pickplace-de/hexagon/Hardware/Kicad/RA8M1.kicad_pcb

## KiCad design Hardware/Kicad/RA8M1.kicad_pcb (2025-03-24)

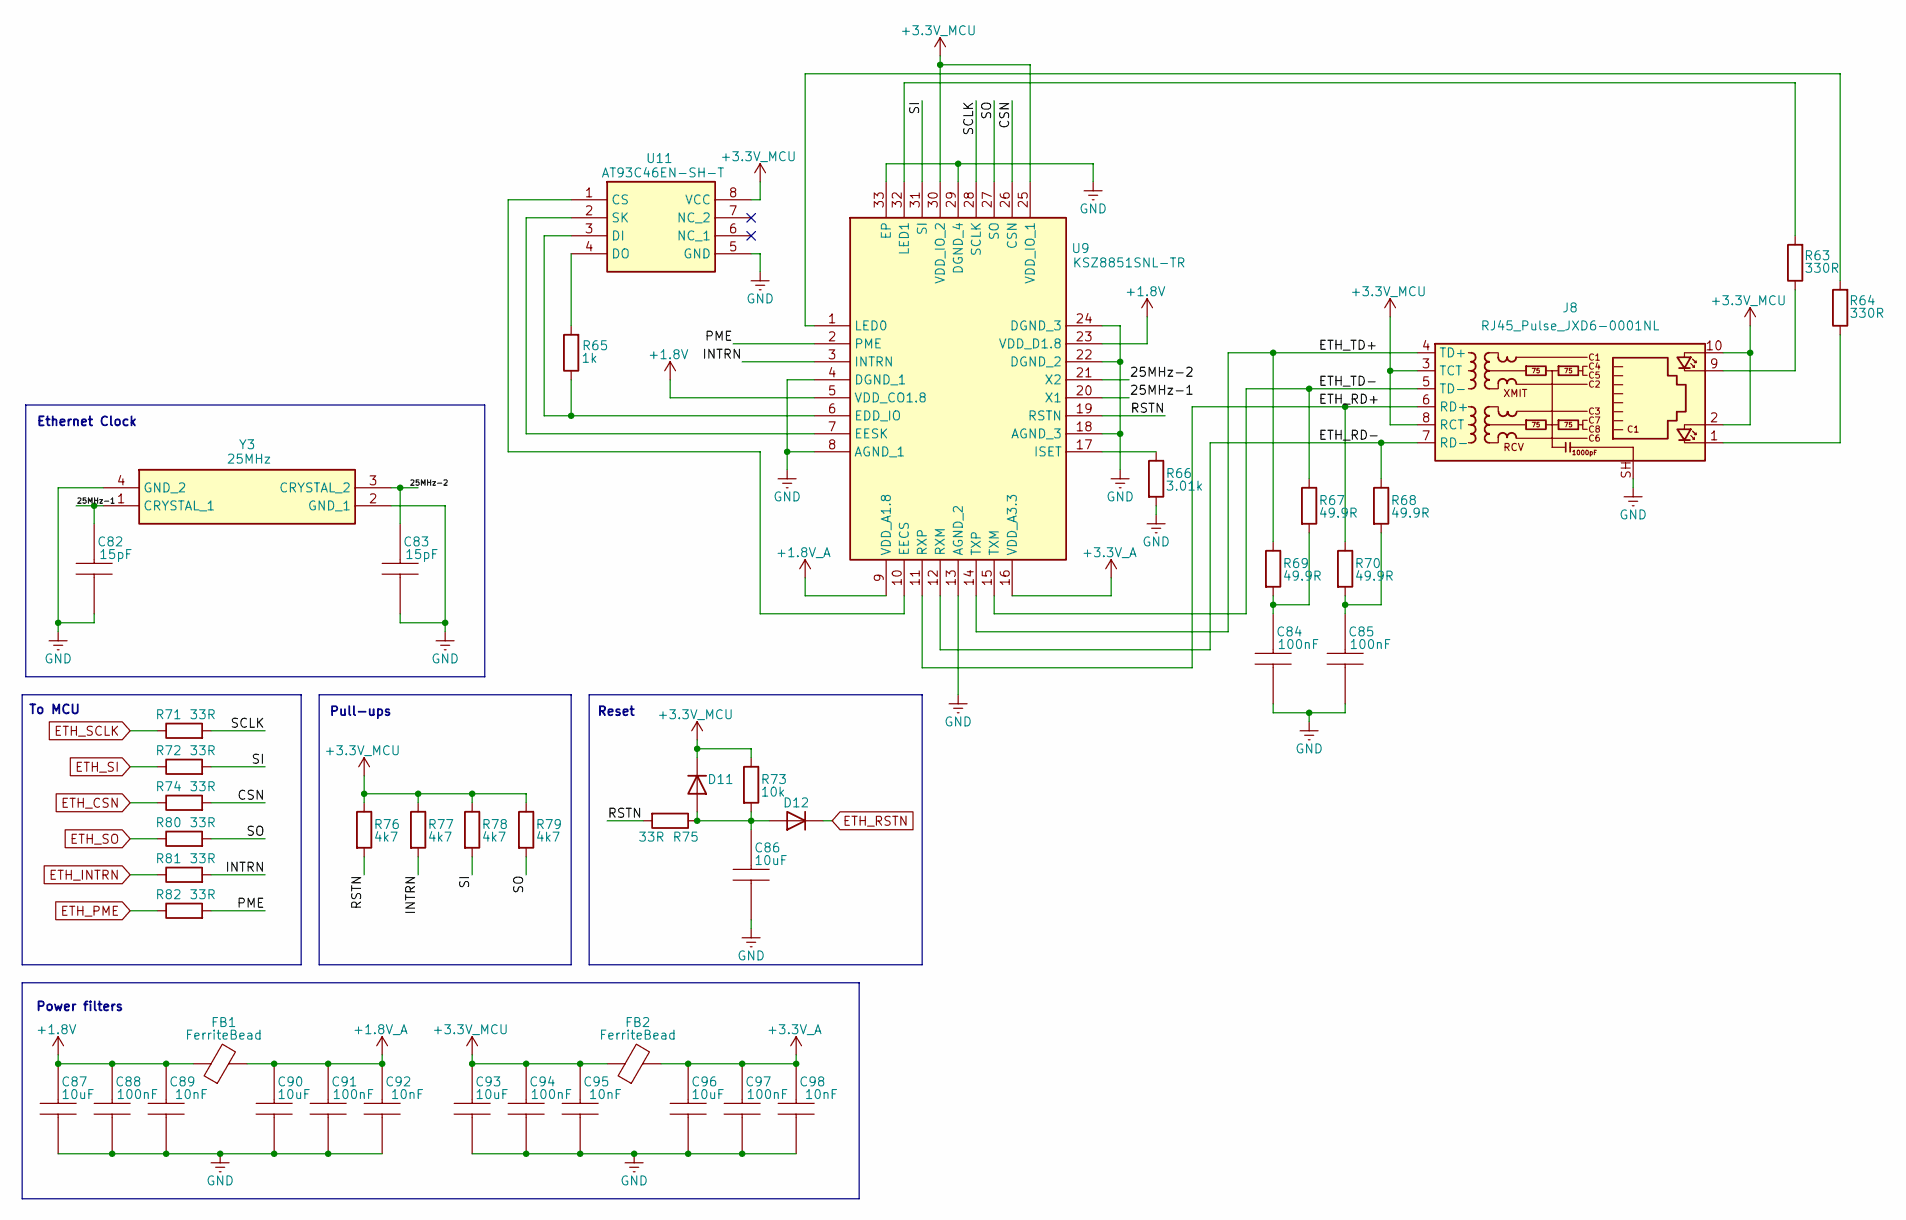
[picture p2: schematic Ethernet.kicad_sch]

Parts:
C82, C83: 15pF; C_0402_1005Metric; MPN 885012005008
C84, C85, C88, C91, C94, C97: 100nF; C_0402_1005Metric; MPN 885012205092
C86, C87, C90, C93, C96: 10uF; C_0402_1005Metric; MPN 885012105020
C89, C92, C95, C98: 10nF; C_0402_1005Metric; MPN 885012205031
D11, D12: 1N4148W; D_SOD-123; MPN 1N4148W-7-F
FB1, FB2: FerriteBead; L_0805_2012Metric; MPN 742792040
J8: RJ45_Pulse_JXD6-0001NL; RJ45_Pulse_JXD6-0001NL_Horizontal; MPN JXD6-0001NL
R63, R64: 330R; R_0402_1005Metric; MPN 560112110231
R65: 1k; R_0402_1005Metric; MPN 560112110012
R66: 3.01k; R_0402_1005Metric; MPN CR0402-FX-3011GLF
R67, R68, R69, R70: 49.9R; R_0402_1005Metric; MPN 560112110002
R71, R72, R74, R75, R80, R81, R82: 33R; R_0402_1005Metric; MPN 560112110004
R73: 10k; R_0402_1005Metric; MPN 560112110020
R76, R77, R78, R79: 4k7; R_0402_1005Metric; MPN 560112110245
U9: KSZ8851SNL-TR; QFN50P500X500X100-33N-D; Mouser Part Number 998-KSZ8851SNLTR
U11: AT93C46EN-SH-T; SOIC127P600X175-8N; Mouser Part Number 556-A93C46ENSHT
Y3: 25MHz; 830108208209; Mouser Part Number 830107871909

Connections:
+1.8V: C87.2, C88.2, C89.2, FB1.1, U9.5 (VDD_CO1.8), U9.23 (VDD_D1.8); also elsewhere on the board
+1.8V_A: C90.2, C91.2, C92.2, FB1.2, U9.9 (VDD_A1.8)
+3.3V_A: C96.2, C97.2, C98.2, FB2.2, U9.16 (VDD_A3.3)
+3.3V_MCU: C93.2, C94.2, C95.2, D11.1 (K), FB2.1, J8.2, J8.3 (TCT), J8.8 (RCT), J8.10, R73.1, R76.1, R77.1, R78.1, R79.1, U9.25 (VDD_IO_1), U9.30 (VDD_IO_2), U11.8 (VCC); also elsewhere on the board
/ETHERNET/25MHz-1: C82.2, U9.20 (X1), Y3.1 (CRYSTAL_1)
/ETHERNET/25MHz-2: C83.2, U9.21 (X2), Y3.3 (CRYSTAL_2)
/ETHERNET/CSN: R74.2, U9.26 (CSN)
/ETHERNET/ETH_RD+: J8.6 (RD+), R70.1, U9.11 (RXP)
/ETHERNET/ETH_RD-: J8.7 (RD-), R68.1, U9.12 (RXM)
/ETHERNET/ETH_TD+: J8.4 (TD+), R69.1, U9.14 (TXP)
/ETHERNET/ETH_TD-: J8.5 (TD-), R67.1, U9.15 (TXM)
/ETHERNET/INTRN: R77.2, R81.2, U9.3 (INTRN)
/ETHERNET/PME: R82.2, U9.2 (PME)
/ETHERNET/RSTN: R75.2, R76.2, U9.19 (RSTN)
/ETHERNET/SCLK: R71.2, U9.28 (SCLK)
/ETHERNET/SI: R72.2, R78.2, U9.31 (SI)
/ETHERNET/SO: R79.2, R80.2, U9.27 (SO)
ETH_CSN: R74.1; also elsewhere on the board
ETH_INTRN: R81.1; also elsewhere on the board
ETH_PME: R82.1; also elsewhere on the board
ETH_RSTN: D12.1 (K); also elsewhere on the board
ETH_SCLK: R71.1; also elsewhere on the board
ETH_SI: R72.1; also elsewhere on the board
ETH_SO: R80.1; also elsewhere on the board
GND: C82.1, C83.1, C84.1, C85.1, C86.1, C87.1, C88.1, C89.1, C90.1, C91.1, C92.1, C93.1, C94.1, C95.1, C96.1, C97.1, C98.1, J8.SH, R66.2, U9.4 (DGND_1), U9.8 (AGND_1), U9.13 (AGND_2), U9.18 (AGND_3), U9.22 (DGND_2), U9.24 (DGND_3), U9.29 (DGND_4), U9.33 (EP), U11.5 (GND), Y3.2 (GND_1), Y3.4 (GND_2); also elsewhere on the board
unnamed: C84.2, R67.2, R69.2
unnamed: C85.2, R68.2, R70.2
unnamed: C86.2, D11.2 (A), D12.2 (A), R73.2, R75.1
unnamed: J8.1, R64.1
unnamed: J8.9, R63.1
unnamed: R66.1, U9.17 (ISET)
unnamed: R64.2, U9.1 (LED0)
unnamed: R63.2, U9.32 (LED1)
unnamed: U9.10 (EECS), U11.1 (CS)
unnamed: R65.1, U9.6 (EDD_IO), U11.3 (DI)
unnamed: R65.2, U11.4 (DO)
unnamed: U9.7 (EESK), U11.2 (SK)

Notes on the sheet:
Power filters
To MCU
Pull-ups
Reset
Ethernet Clock

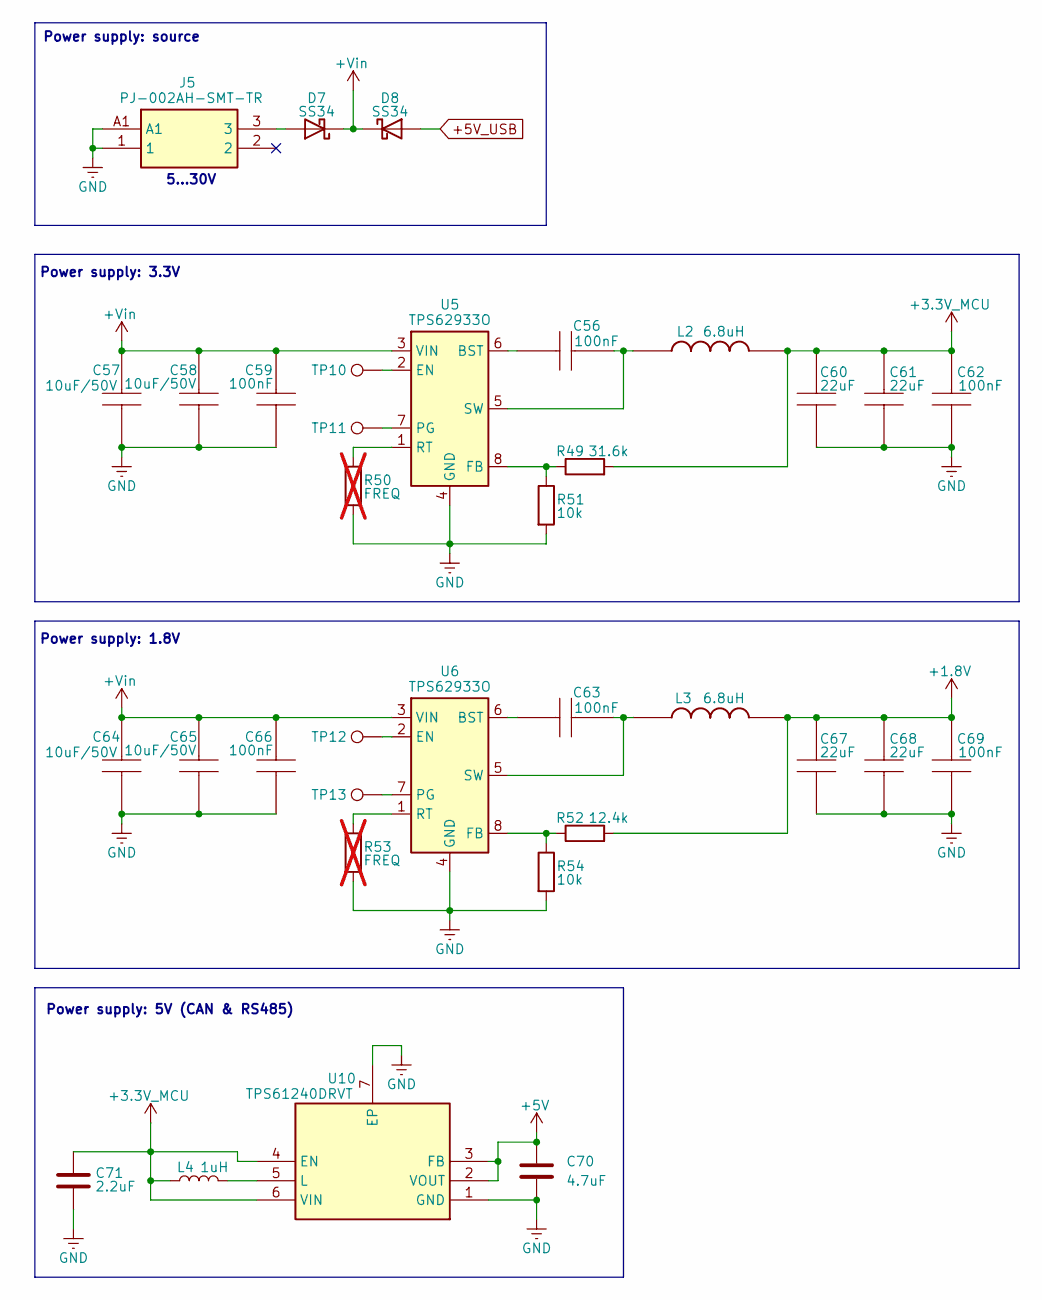
[picture p3: schematic PS.kicad_sch]

Parts:
C56, C59, C62, C63, C66, C69: 100nF; C_0402_1005Metric; MPN 885012205092
C57, C58, C64, C65: 10uF/50V; C_0805_2012Metric; MPN C2012X5R1H106K125AC
C60, C61, C67, C68: 22uF; C_0805_2012Metric; MPN 885012107005
C70: 4.7uF; C_0402_1005Metric; MPN 885012105008
C71: 2.2uF; C_0402_1005Metric; MPN 885012105007
D7, D8: SS34; D_SMA
J5: PJ-002AH-SMT-TR; PJ002AHSMTTR; Mouser Part Number 490-PJ-002AH-SMT-TR
L2, L3: 6.8uH; INDPM4141X310N; Mouser Part Number 710-74438357068
L4: 1uH; L_0603_1608Metric; MPN 74479763210A
R49: 31.6k; R_0402_1005Metric; MPN CR0603-FX-3162ELF
R50, R53: FREQ; R_0402_1005Metric; MPN 560112110001; not fitted
R51, R54: 10k; R_0402_1005Metric; MPN 560112110020
R52: 12.4k; R_0402_1005Metric; MPN CR0402-FX-1242GLF
TP10, TP11, TP12, TP13: TestPoint_0.5mm
U5, U6: TPS62933O; SOT-583-8; MPN TPS62933ODRLR
U10: TPS61240DRVT; SON65P200X200X80-7N; Mouser Part Number 595-TPS61240DRVT

Connections:
+1.8V: C67.2, C68.2, C69.2, L3.2, R52.2; also elsewhere on the board
+3.3V_MCU: C60.2, C61.2, C62.2, C71.1, L2.2, L4.1, R49.2, U10.4 (EN), U10.6 (VIN); also elsewhere on the board
+5V: C70.1, U10.2 (VOUT), U10.3 (FB); also elsewhere on the board
+5V_USB: D8.2 (A); also elsewhere on the board
+Vin: C57.2, C58.2, C59.2, C64.2, C65.2, C66.2, D7.1 (K), D8.1 (K), U5.3 (VIN), U6.3 (VIN)
GND: C57.1, C58.1, C59.1, C60.1, C61.1, C62.1, C64.1, C65.1, C66.1, C67.1, C68.1, C69.1, C70.2, C71.2, J5.1, J5.A1, R50.2, R51.2, R53.2, R54.2, U5.4 (GND), U6.4 (GND), U10.1 (GND), U10.7 (EP); also elsewhere on the board
unnamed: D7.2 (A), J5.3
unnamed: C56.2, U5.6 (BST)
unnamed: TP10.1, U5.2 (EN)
unnamed: R49.1, R51.1, U5.8 (FB)
unnamed: TP11.1, U5.7 (PG)
unnamed: R50.1, U5.1 (RT)
unnamed: C56.1, L2.1, U5.5 (SW)
unnamed: C63.2, U6.6 (BST)
unnamed: TP12.1, U6.2 (EN)
unnamed: R52.1, R54.1, U6.8 (FB)
unnamed: TP13.1, U6.7 (PG)
unnamed: R53.1, U6.1 (RT)
unnamed: C63.1, L3.1, U6.5 (SW)
unnamed: L4.2, U10.5 (L)

Notes on the sheet:
Power supply: 5V (CAN & RS485)
Power supply: 3.3V
Power supply: source
Power supply: 1.8V
5...30V

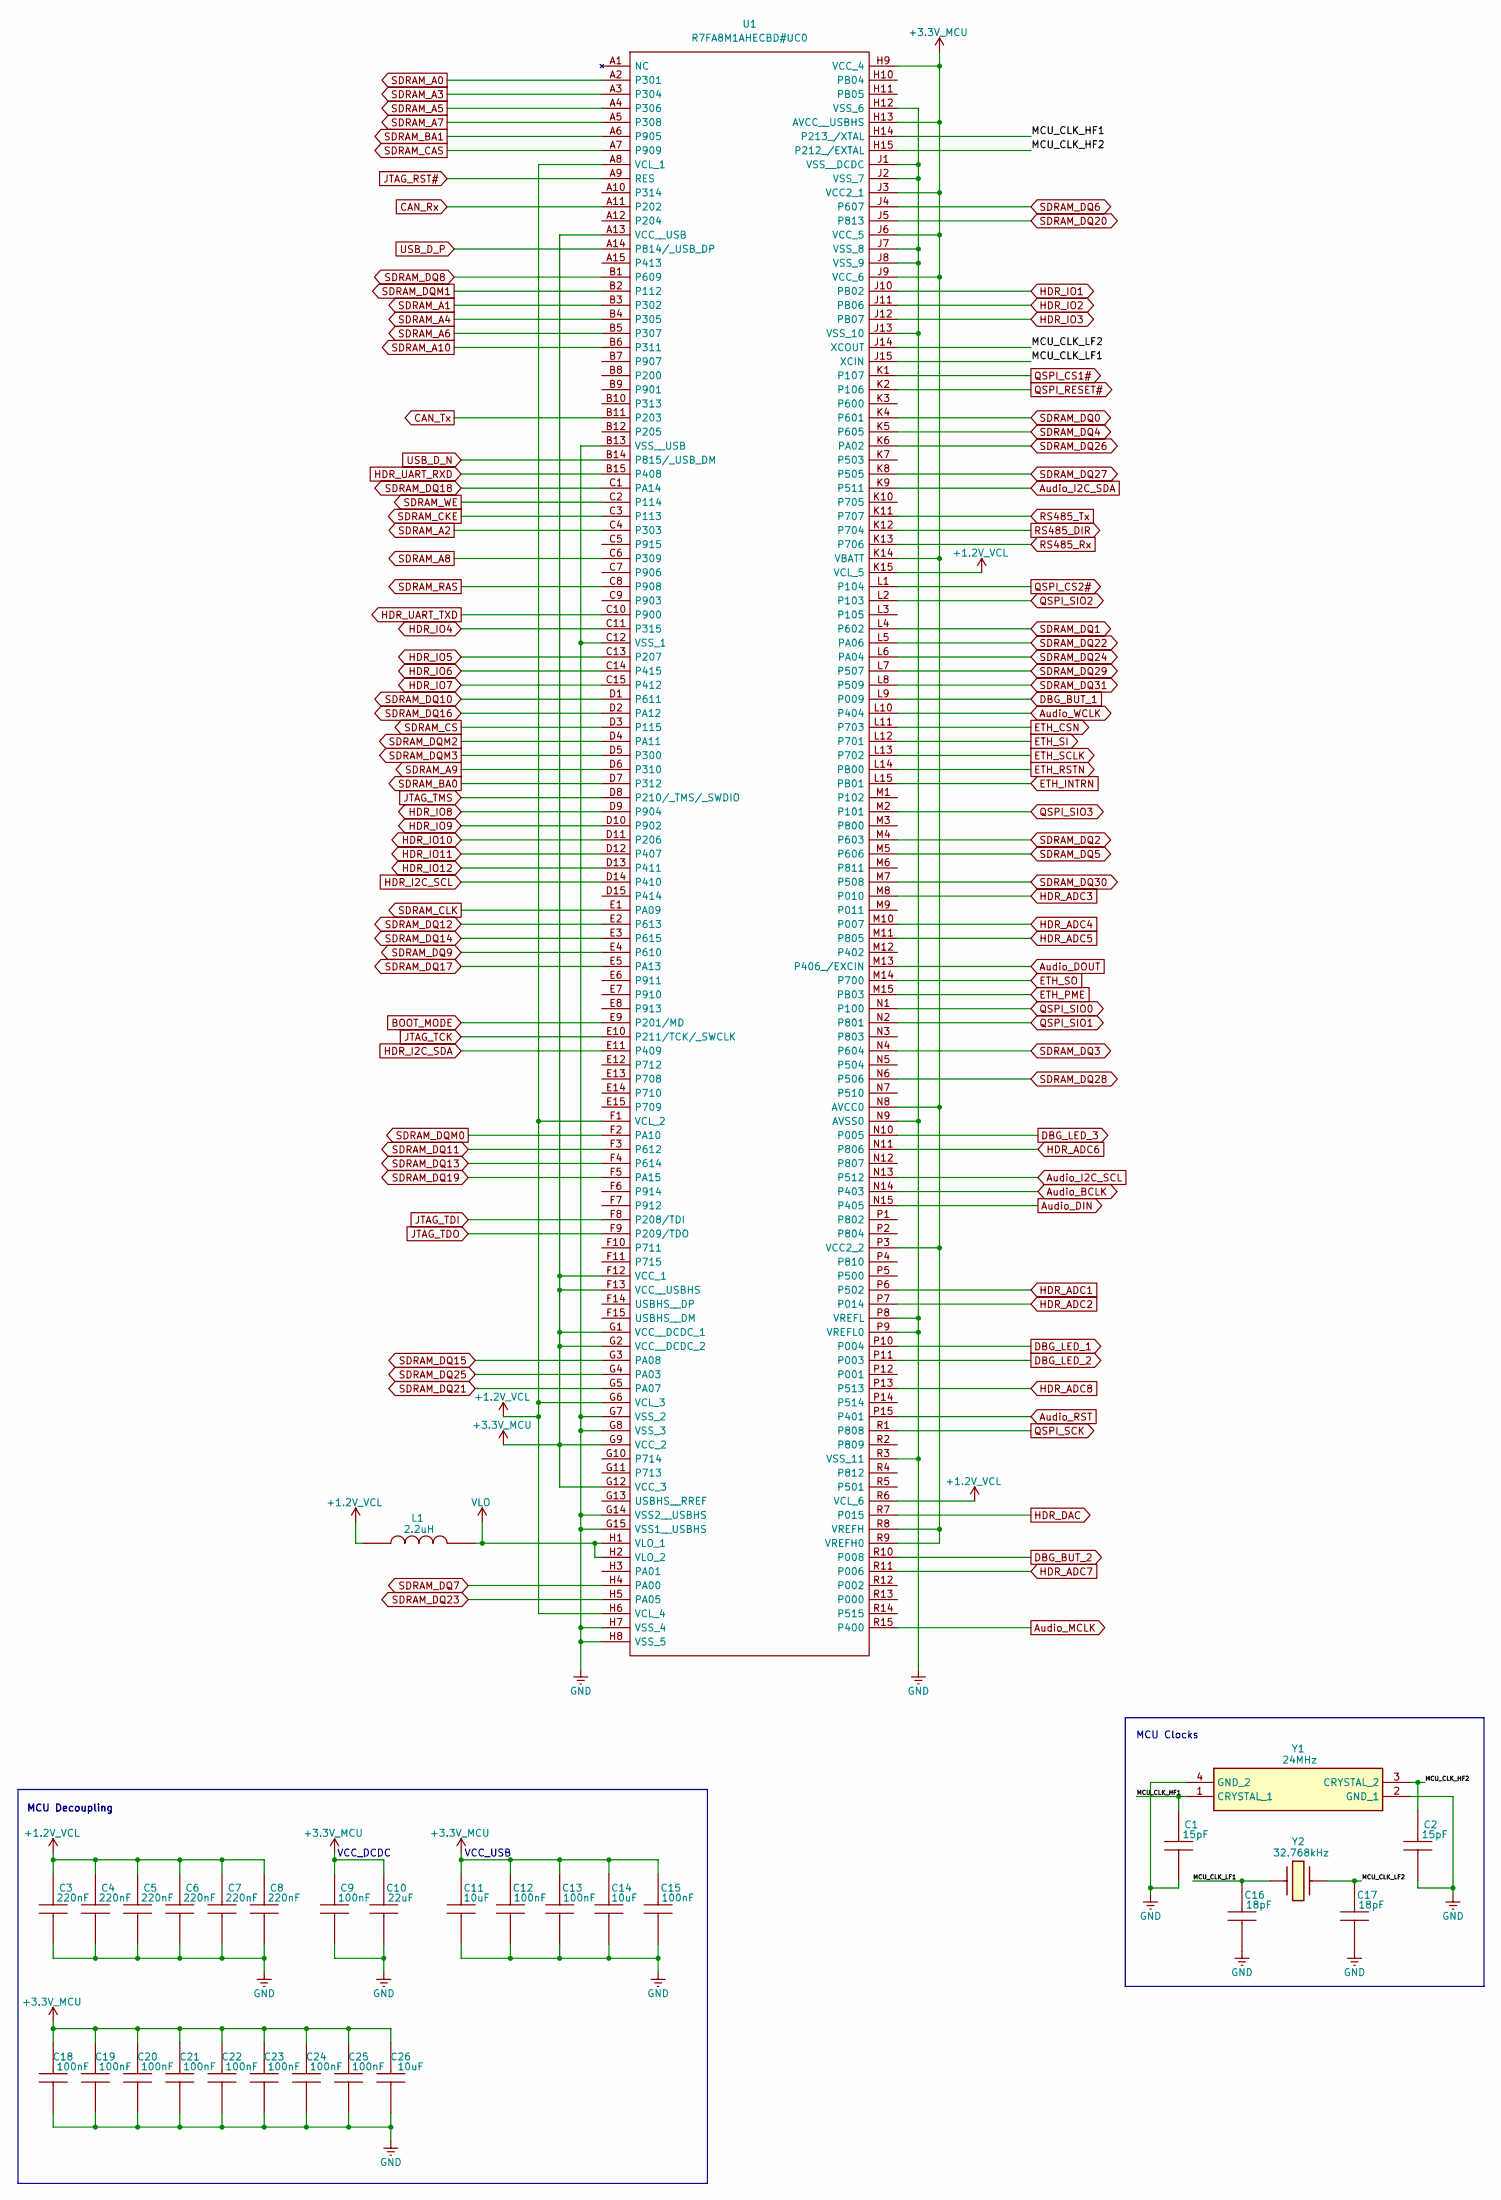
[picture p4: schematic MCU.kicad_sch, RA8M1 Development Board]

Parts:
C1, C2: 15pF; C_0402_1005Metric; MPN 885012005008
C3, C4, C5, C6, C7, C8: 220nF; C_0402_1005Metric; MPN 885012105011
C9, C12, C13, C15, C18, C19, C20, C21, C22, C23, C24, C25: 100nF; C_0402_1005Metric; MPN 885012205092
C10: 22uF; C_0805_2012Metric; MPN 885012107005
C11, C14, C26: 10uF; C_0402_1005Metric; MPN 885012105020
C16, C17: 18pF; C_0402_1005Metric; MPN 04023A180CAT2A
L1: 2.2uH; LQM21PHR47NG0D; Mouser Part Number 81-LQM21PN2R2NGCDCD
U1: R7FA8M1AHECBD#UC0; BGA225C80P15X15_1300X1300X147; MPN R7FA8M1AHECBD#UC0
Y1: 24MHz; 830108208209; Mouser Part Number 710-830108208209
Y2: 32.768kHz; 830050789; Mouser Part Number 710-830050789

Connections:
+1.2V_VCL: C3.2, C4.2, C5.2, C6.2, C7.2, C8.2, L1.2, U1.A8 (VCL_1), U1.F1 (VCL_2), U1.G6 (VCL_3), U1.H6 (VCL_4), U1.K15 (VCL_5), U1.R6 (VCL_6)
+3.3V_MCU: C9.2, C10.2, C11.2, C12.2, C13.2, C14.2, C15.2, C18.2, C19.2, C20.2, C21.2, C22.2, C23.2, C24.2, C25.2, C26.2, U1.A13 (VCC__USB), U1.F12 (VCC_1), U1.F13 (VCC__USBHS), U1.G1 (VCC__DCDC_1), U1.G2 (VCC__DCDC_2), U1.G9 (VCC_2), U1.G12 (VCC_3), U1.H9 (VCC_4), U1.H13 (AVCC__USBHS), U1.J3 (VCC2_1), U1.J6 (VCC_5), U1.J9 (VCC_6), U1.K14 (VBATT), U1.N8 (AVCC0), U1.P3 (VCC2_2), U1.R8 (VREFH), U1.R9 (VREFH0); also elsewhere on the board
/MCU/MCU_CLK_HF1: C1.2, U1.H14 (P213_/XTAL), Y1.1 (CRYSTAL_1)
/MCU/MCU_CLK_HF2: C2.2, U1.H15 (P212_/EXTAL), Y1.3 (CRYSTAL_2)
/MCU/MCU_CLK_LF1: C16.2, U1.J15 (XCIN), Y2.1
/MCU/MCU_CLK_LF2: C17.2, U1.J14 (XCOUT), Y2.2
Audio_BCLK: U1.N14 (P403); also elsewhere on the board
Audio_DIN: U1.N15 (P405); also elsewhere on the board
Audio_DOUT: U1.M13 (P406_/EXCIN); also elsewhere on the board
Audio_I2C_SCL: U1.N13 (P512); also elsewhere on the board
Audio_I2C_SDA: U1.K9 (P511); also elsewhere on the board
Audio_MCLK: U1.R15 (P400); also elsewhere on the board
Audio_RST: U1.P15 (P401); also elsewhere on the board
Audio_WCLK: U1.L10 (P404); also elsewhere on the board
BOOT_MODE: U1.E9 (P201/MD); also elsewhere on the board
CAN_Rx: U1.A11 (P202); also elsewhere on the board
CAN_Tx: U1.B11 (P203); also elsewhere on the board
DBG_BUT_1: U1.L9 (P009); also elsewhere on the board
DBG_BUT_2: U1.R10 (P008); also elsewhere on the board
DBG_LED_1: U1.P10 (P004); also elsewhere on the board
DBG_LED_2: U1.P11 (P003); also elsewhere on the board
DBG_LED_3: U1.N10 (P005); also elsewhere on the board
ETH_CSN: U1.L11 (P703); also elsewhere on the board
ETH_INTRN: U1.L15 (PB01); also elsewhere on the board
ETH_PME: U1.M15 (PB03); also elsewhere on the board
ETH_RSTN: U1.L14 (PB00); also elsewhere on the board
ETH_SCLK: U1.L13 (P702); also elsewhere on the board
ETH_SI: U1.L12 (P701); also elsewhere on the board
ETH_SO: U1.M14 (P700); also elsewhere on the board
GND: C1.1, C2.1, C3.1, C4.1, C5.1, C6.1, C7.1, C8.1, C9.1, C10.1, C11.1, C12.1, C13.1, C14.1, C15.1, C16.1, C17.1, C18.1, C19.1, C20.1, C21.1, C22.1, C23.1, C24.1, C25.1, C26.1, U1.B13 (VSS__USB), U1.C12 (VSS_1), U1.G7 (VSS_2), U1.G8 (VSS_3), U1.G14 (VSS2__USBHS), U1.G15 (VSS1__USBHS), U1.H7 (VSS_4), U1.H8 (VSS_5), U1.H12 (VSS_6), U1.J1 (VSS__DCDC), U1.J2 (VSS_7), U1.J7 (VSS_8), U1.J8 (VSS_9), U1.J13 (VSS_10), U1.N9 (AVSS0), U1.P8 (VREFL), U1.P9 (VREFL0), U1.R3 (VSS_11), Y1.2 (GND_1), Y1.4 (GND_2); also elsewhere on the board
HDR_ADC1: U1.P6 (P502); also elsewhere on the board
HDR_ADC2: U1.P7 (P014); also elsewhere on the board
HDR_ADC3: U1.M8 (P010); also elsewhere on the board
HDR_ADC4: U1.M10 (P007); also elsewhere on the board
HDR_ADC5: U1.M11 (P805); also elsewhere on the board
HDR_ADC6: U1.N11 (P806); also elsewhere on the board
HDR_ADC7: U1.R11 (P006); also elsewhere on the board
HDR_ADC8: U1.P13 (P513); also elsewhere on the board
HDR_DAC: U1.R7 (P015); also elsewhere on the board
HDR_I2C_SCL: U1.D14 (P410); also elsewhere on the board
HDR_I2C_SDA: U1.E11 (P409); also elsewhere on the board
HDR_IO1: U1.J10 (PB02); also elsewhere on the board
HDR_IO2: U1.J11 (PB06); also elsewhere on the board
HDR_IO3: U1.J12 (PB07); also elsewhere on the board
HDR_IO4: U1.C11 (P315); also elsewhere on the board
HDR_IO5: U1.C13 (P207); also elsewhere on the board
HDR_IO6: U1.C14 (P415); also elsewhere on the board
HDR_IO7: U1.C15 (P412); also elsewhere on the board
HDR_IO8: U1.D9 (P904); also elsewhere on the board
HDR_IO9: U1.D10 (P902); also elsewhere on the board
HDR_IO10: U1.D11 (P206); also elsewhere on the board
HDR_IO11: U1.D12 (P407); also elsewhere on the board
HDR_IO12: U1.D13 (P411); also elsewhere on the board
HDR_UART_RXD: U1.B15 (P408); also elsewhere on the board
HDR_UART_TXD: U1.C10 (P900); also elsewhere on the board
JTAG_RST#: U1.A9 (RES); also elsewhere on the board
JTAG_TCK: U1.E10 (P211/TCK/_SWCLK); also elsewhere on the board
JTAG_TDI: U1.F8 (P208/TDI); also elsewhere on the board
JTAG_TDO: U1.F9 (P209/TDO); also elsewhere on the board
JTAG_TMS: U1.D8 (P210/_TMS/_SWDIO); also elsewhere on the board
QSPI_CS1#: U1.K1 (P107); also elsewhere on the board
QSPI_CS2#: U1.L1 (P104); also elsewhere on the board
QSPI_RESET#: U1.K2 (P106); also elsewhere on the board
QSPI_SCK: U1.R1 (P808); also elsewhere on the board
QSPI_SIO0: U1.N1 (P100); also elsewhere on the board
QSPI_SIO1: U1.N2 (P801); also elsewhere on the board
QSPI_SIO2: U1.L2 (P103); also elsewhere on the board
QSPI_SIO3: U1.M2 (P101); also elsewhere on the board
RS485_DIR: U1.K12 (P704); also elsewhere on the board
RS485_Rx: U1.K13 (P706); also elsewhere on the board
RS485_Tx: U1.K11 (P707); also elsewhere on the board
SDRAM_A0: U1.A2 (P301); also elsewhere on the board
SDRAM_A1: U1.B3 (P302); also elsewhere on the board
SDRAM_A2: U1.C4 (P303); also elsewhere on the board
SDRAM_A3: U1.A3 (P304); also elsewhere on the board
SDRAM_A4: U1.B4 (P305); also elsewhere on the board
SDRAM_A5: U1.A4 (P306); also elsewhere on the board
SDRAM_A6: U1.B5 (P307); also elsewhere on the board
SDRAM_A7: U1.A5 (P308); also elsewhere on the board
SDRAM_A8: U1.C6 (P309); also elsewhere on the board
SDRAM_A9: U1.D6 (P310); also elsewhere on the board
SDRAM_A10: U1.B6 (P311); also elsewhere on the board
SDRAM_BA0: U1.D7 (P312); also elsewhere on the board
SDRAM_BA1: U1.A6 (P905); also elsewhere on the board
SDRAM_CAS: U1.A7 (P909); also elsewhere on the board
SDRAM_CKE: U1.C3 (P113); also elsewhere on the board
SDRAM_CLK: U1.E1 (PA09); also elsewhere on the board
SDRAM_CS: U1.D3 (P115); also elsewhere on the board
SDRAM_DQ0: U1.K4 (P601); also elsewhere on the board
SDRAM_DQ1: U1.L4 (P602); also elsewhere on the board
SDRAM_DQ2: U1.M4 (P603); also elsewhere on the board
SDRAM_DQ3: U1.N4 (P604); also elsewhere on the board
SDRAM_DQ4: U1.K5 (P605); also elsewhere on the board
SDRAM_DQ5: U1.M5 (P606); also elsewhere on the board
SDRAM_DQ6: U1.J4 (P607); also elsewhere on the board
SDRAM_DQ7: U1.H4 (PA00); also elsewhere on the board
SDRAM_DQ8: U1.B1 (P609); also elsewhere on the board
SDRAM_DQ9: U1.E4 (P610); also elsewhere on the board
SDRAM_DQ10: U1.D1 (P611); also elsewhere on the board
SDRAM_DQ11: U1.F3 (P612); also elsewhere on the board
SDRAM_DQ12: U1.E2 (P613); also elsewhere on the board
SDRAM_DQ13: U1.F4 (P614); also elsewhere on the board
SDRAM_DQ14: U1.E3 (P615); also elsewhere on the board
SDRAM_DQ15: U1.G3 (PA08); also elsewhere on the board
SDRAM_DQ16: U1.D2 (PA12); also elsewhere on the board
SDRAM_DQ17: U1.E5 (PA13); also elsewhere on the board
SDRAM_DQ18: U1.C1 (PA14); also elsewhere on the board
SDRAM_DQ19: U1.F5 (PA15); also elsewhere on the board
SDRAM_DQ20: U1.J5 (P813); also elsewhere on the board
SDRAM_DQ21: U1.G5 (PA07); also elsewhere on the board
SDRAM_DQ22: U1.L5 (PA06); also elsewhere on the board
SDRAM_DQ23: U1.H5 (PA05); also elsewhere on the board
SDRAM_DQ24: U1.L6 (PA04); also elsewhere on the board
SDRAM_DQ25: U1.G4 (PA03); also elsewhere on the board
SDRAM_DQ26: U1.K6 (PA02); also elsewhere on the board
SDRAM_DQ27: U1.K8 (P505); also elsewhere on the board
SDRAM_DQ28: U1.N6 (P506); also elsewhere on the board
SDRAM_DQ29: U1.L7 (P507); also elsewhere on the board
SDRAM_DQ30: U1.M7 (P508); also elsewhere on the board
SDRAM_DQ31: U1.L8 (P509); also elsewhere on the board
SDRAM_DQM0: U1.F2 (PA10); also elsewhere on the board
SDRAM_DQM1: U1.B2 (P112); also elsewhere on the board
SDRAM_DQM2: U1.D4 (PA11); also elsewhere on the board
SDRAM_DQM3: U1.D5 (P300); also elsewhere on the board
SDRAM_RAS: U1.C8 (P908); also elsewhere on the board
SDRAM_WE: U1.C2 (P114); also elsewhere on the board
USB_D_N: U1.B14 (P815/_USB_DM); also elsewhere on the board
USB_D_P: U1.A14 (P814/_USB_DP); also elsewhere on the board
VLO: L1.1, U1.H1 (VLO_1), U1.H2 (VLO_2)

Notes on the sheet:
VCC_USB
MCU Decoupling
VCC_DCDC
MCU Clocks

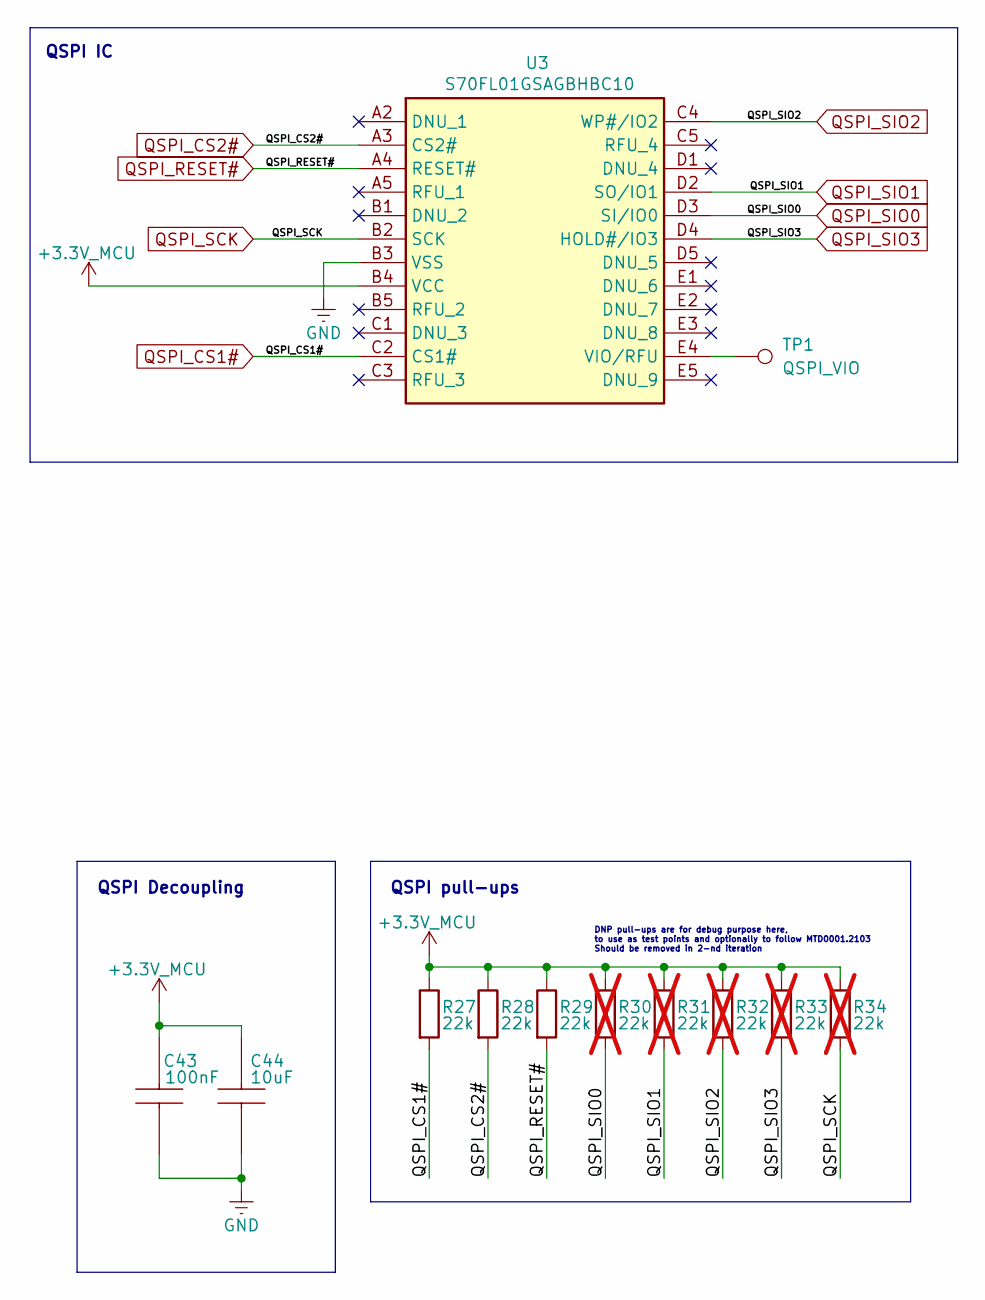
[picture p5: schematic QSPI.kicad_sch]

Parts:
C43: 100nF; C_0402_1005Metric; MPN 885012205092
C44: 10uF; C_0402_1005Metric; MPN 885012105020
R27, R28, R29: 22k; R_0402_1005Metric; MPN 560112110098
R30, R31, R32, R33, R34: 22k; R_0402_1005Metric; MPN 560112110098; not fitted
TP1: QSPI_VIO; TestPoint_0.5mm
U3: S70FL01GSAGBHBC10; BGA24C100P5X5_600X800X120; Mouser Part Number 727-S70FL01GSAGBHC10

Connections:
+3.3V_MCU: C43.2, C44.2, R27.1, R28.1, R29.1, R30.1, R31.1, R32.1, R33.1, R34.1, U3.B4 (VCC); also elsewhere on the board
GND: C43.1, C44.1, U3.B3 (VSS); also elsewhere on the board
unnamed: TP1.1, U3.E4 (VIO/RFU)
QSPI_CS1#: R27.2, U3.C2 (CS1#); also elsewhere on the board
QSPI_CS2#: R28.2, U3.A3 (CS2#); also elsewhere on the board
QSPI_RESET#: R29.2, U3.A4 (RESET#); also elsewhere on the board
QSPI_SCK: R34.2, U3.B2 (SCK); also elsewhere on the board
QSPI_SIO0: R30.2, U3.D3 (SI/IO0); also elsewhere on the board
QSPI_SIO1: R31.2, U3.D2 (SO/IO1); also elsewhere on the board
QSPI_SIO2: R32.2, U3.C4 (WP#/IO2); also elsewhere on the board
QSPI_SIO3: R33.2, U3.D4 (HOLD#/IO3); also elsewhere on the board

Notes on the sheet:
QSPI IC
DNP pull-ups are for debug purpose here, to use as test points and optionally to follow MTD0001.2103 Should be removed in 2-nd iteration
QSPI Decoupling
QSPI pull-ups

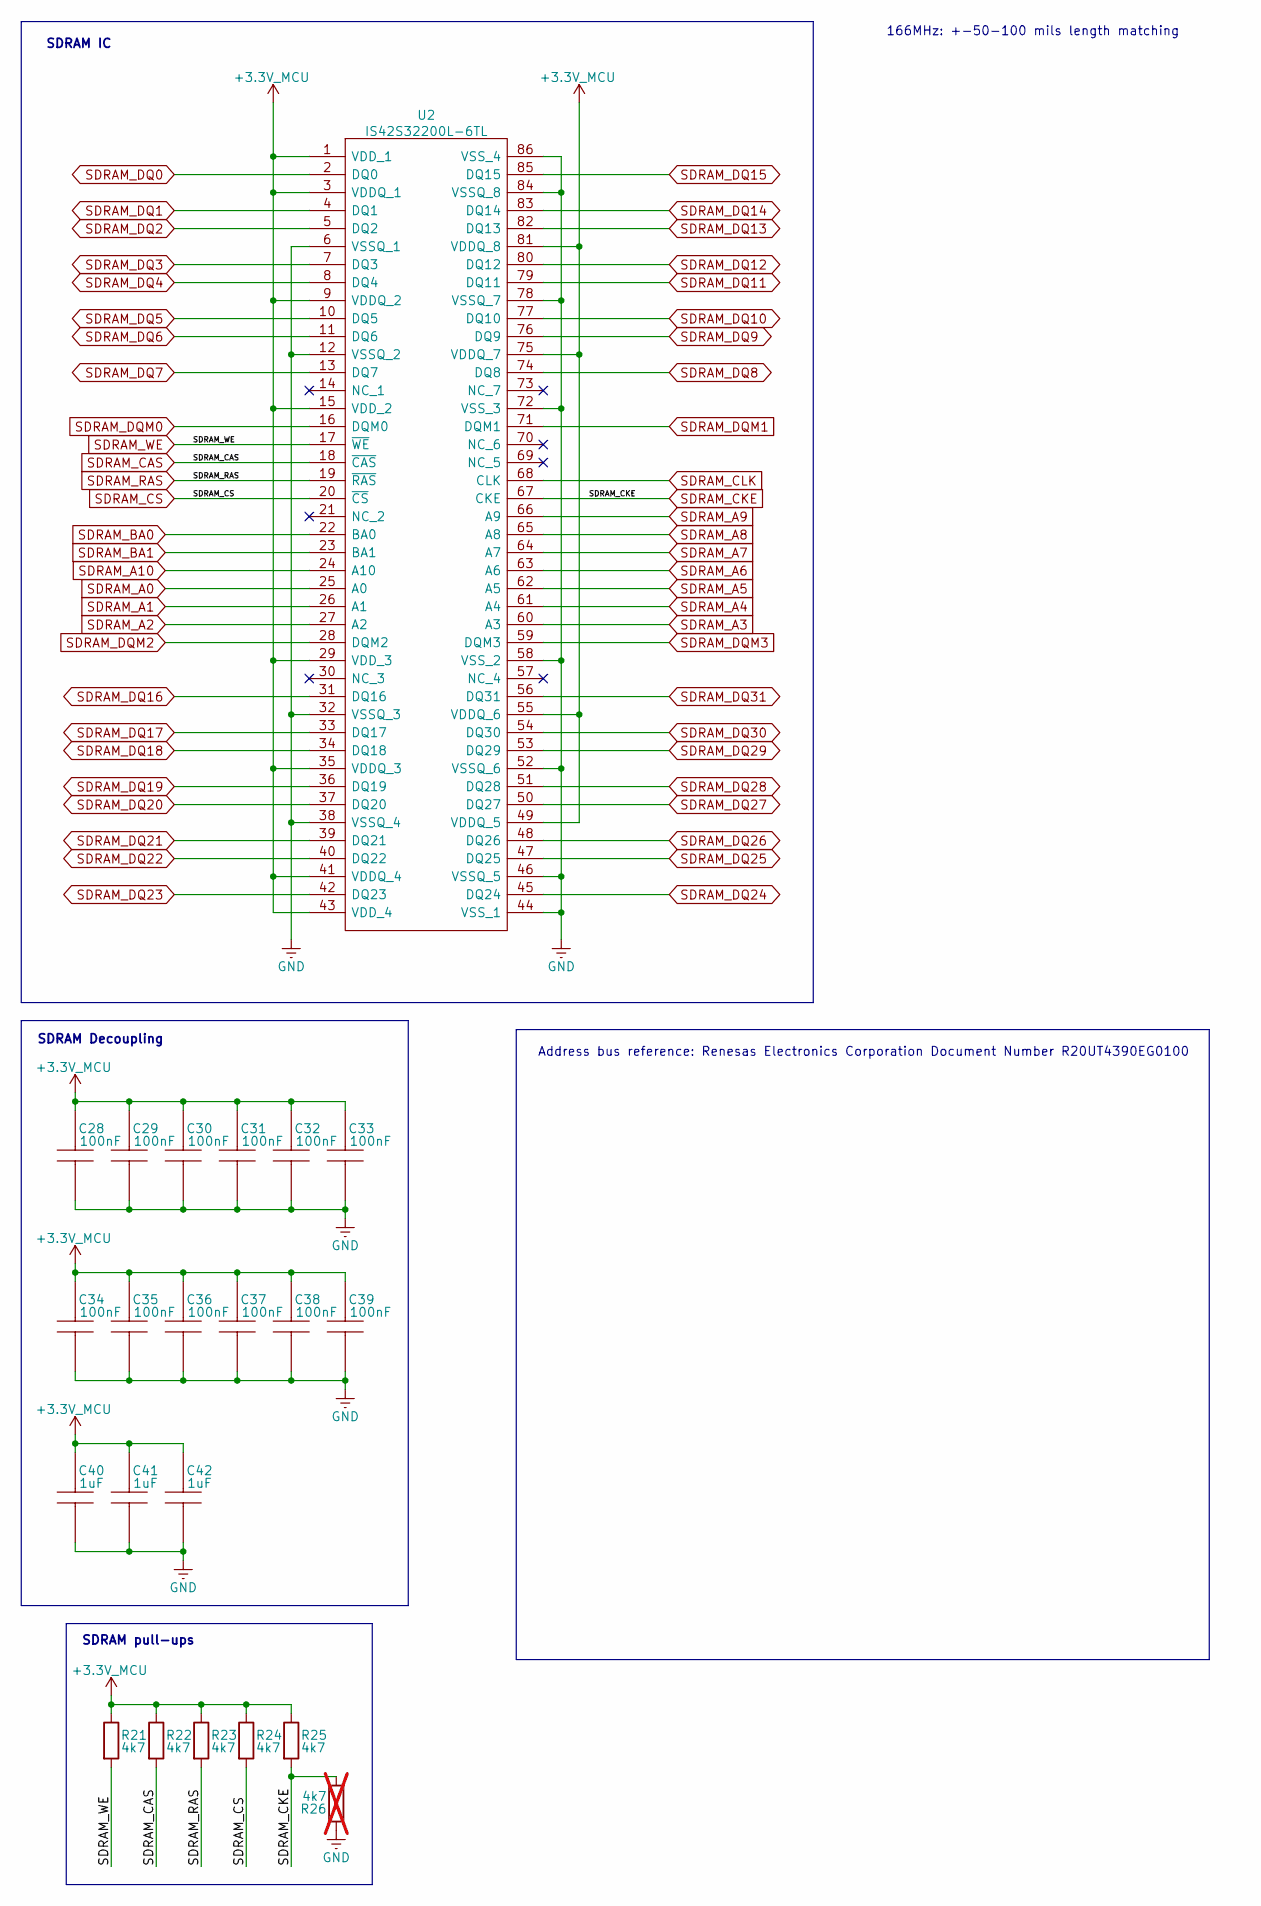
[picture p6: schematic SDRAM.kicad_sch]

Parts:
C28, C29, C30, C31, C32, C33, C34, C35, C36, C37, C38, C39: 100nF; C_0402_1005Metric; MPN 885012205092
C40, C41, C42: 1uF; C_0402_1005Metric; MPN 885012105006
R21, R22, R23, R24, R25: 4k7; R_0402_1005Metric; MPN 560112110245
R26: 4k7; R_0402_1005Metric; MPN 560112110245; not fitted
U2: IS42S32200L-6TL; SOP50P1176X120-86N; MPN IS42S32200L-6TL

Connections:
+3.3V_MCU: C28.2, C29.2, C30.2, C31.2, C32.2, C33.2, C34.2, C35.2, C36.2, C37.2, C38.2, C39.2, C40.2, C41.2, C42.2, R21.1, R22.1, R23.1, R24.1, R25.1, U2.1 (VDD_1), U2.3 (VDDQ_1), U2.9 (VDDQ_2), U2.15 (VDD_2), U2.29 (VDD_3), U2.35 (VDDQ_3), U2.41 (VDDQ_4), U2.43 (VDD_4), U2.49 (VDDQ_5), U2.55 (VDDQ_6), U2.75 (VDDQ_7), U2.81 (VDDQ_8); also elsewhere on the board
GND: C28.1, C29.1, C30.1, C31.1, C32.1, C33.1, C34.1, C35.1, C36.1, C37.1, C38.1, C39.1, C40.1, C41.1, C42.1, R26.1, U2.6 (VSSQ_1), U2.12 (VSSQ_2), U2.32 (VSSQ_3), U2.38 (VSSQ_4), U2.44 (VSS_1), U2.46 (VSSQ_5), U2.52 (VSSQ_6), U2.58 (VSS_2), U2.72 (VSS_3), U2.78 (VSSQ_7), U2.84 (VSSQ_8), U2.86 (VSS_4); also elsewhere on the board
SDRAM_A0: U2.25 (A0); also elsewhere on the board
SDRAM_A1: U2.26 (A1); also elsewhere on the board
SDRAM_A2: U2.27 (A2); also elsewhere on the board
SDRAM_A3: U2.60 (A3); also elsewhere on the board
SDRAM_A4: U2.61 (A4); also elsewhere on the board
SDRAM_A5: U2.62 (A5); also elsewhere on the board
SDRAM_A6: U2.63 (A6); also elsewhere on the board
SDRAM_A7: U2.64 (A7); also elsewhere on the board
SDRAM_A8: U2.65 (A8); also elsewhere on the board
SDRAM_A9: U2.66 (A9); also elsewhere on the board
SDRAM_A10: U2.24 (A10); also elsewhere on the board
SDRAM_BA0: U2.22 (BA0); also elsewhere on the board
SDRAM_BA1: U2.23 (BA1); also elsewhere on the board
SDRAM_CAS: R22.2, U2.18 (~CAS); also elsewhere on the board
SDRAM_CKE: R25.2, R26.2, U2.67 (CKE); also elsewhere on the board
SDRAM_CLK: U2.68 (CLK); also elsewhere on the board
SDRAM_CS: R24.2, U2.20 (~CS); also elsewhere on the board
SDRAM_DQ0: U2.2 (DQ0); also elsewhere on the board
SDRAM_DQ1: U2.4 (DQ1); also elsewhere on the board
SDRAM_DQ2: U2.5 (DQ2); also elsewhere on the board
SDRAM_DQ3: U2.7 (DQ3); also elsewhere on the board
SDRAM_DQ4: U2.8 (DQ4); also elsewhere on the board
SDRAM_DQ5: U2.10 (DQ5); also elsewhere on the board
SDRAM_DQ6: U2.11 (DQ6); also elsewhere on the board
SDRAM_DQ7: U2.13 (DQ7); also elsewhere on the board
SDRAM_DQ8: U2.74 (DQ8); also elsewhere on the board
SDRAM_DQ9: U2.76 (DQ9); also elsewhere on the board
SDRAM_DQ10: U2.77 (DQ10); also elsewhere on the board
SDRAM_DQ11: U2.79 (DQ11); also elsewhere on the board
SDRAM_DQ12: U2.80 (DQ12); also elsewhere on the board
SDRAM_DQ13: U2.82 (DQ13); also elsewhere on the board
SDRAM_DQ14: U2.83 (DQ14); also elsewhere on the board
SDRAM_DQ15: U2.85 (DQ15); also elsewhere on the board
SDRAM_DQ16: U2.31 (DQ16); also elsewhere on the board
SDRAM_DQ17: U2.33 (DQ17); also elsewhere on the board
SDRAM_DQ18: U2.34 (DQ18); also elsewhere on the board
SDRAM_DQ19: U2.36 (DQ19); also elsewhere on the board
SDRAM_DQ20: U2.37 (DQ20); also elsewhere on the board
SDRAM_DQ21: U2.39 (DQ21); also elsewhere on the board
SDRAM_DQ22: U2.40 (DQ22); also elsewhere on the board
SDRAM_DQ23: U2.42 (DQ23); also elsewhere on the board
SDRAM_DQ24: U2.45 (DQ24); also elsewhere on the board
SDRAM_DQ25: U2.47 (DQ25); also elsewhere on the board
SDRAM_DQ26: U2.48 (DQ26); also elsewhere on the board
SDRAM_DQ27: U2.50 (DQ27); also elsewhere on the board
SDRAM_DQ28: U2.51 (DQ28); also elsewhere on the board
SDRAM_DQ29: U2.53 (DQ29); also elsewhere on the board
SDRAM_DQ30: U2.54 (DQ30); also elsewhere on the board
SDRAM_DQ31: U2.56 (DQ31); also elsewhere on the board
SDRAM_DQM0: U2.16 (DQM0); also elsewhere on the board
SDRAM_DQM1: U2.71 (DQM1); also elsewhere on the board
SDRAM_DQM2: U2.28 (DQM2); also elsewhere on the board
SDRAM_DQM3: U2.59 (DQM3); also elsewhere on the board
SDRAM_RAS: R23.2, U2.19 (~RAS); also elsewhere on the board
SDRAM_WE: R21.2, U2.17 (~WE); also elsewhere on the board

Notes on the sheet:
SDRAM pull-ups
SDRAM Decoupling
SDRAM IC
Address bus reference: Renesas Electronics Corporation Document Number R20UT4390EG0100
166MHz: +-50-100 mils length matching
