pickplace-de/hexagon/Hardware/Kicad/RA8M1.kicad_pcb

## KiCad design Hardware/Kicad/RA8M1.kicad_pcb (continued)

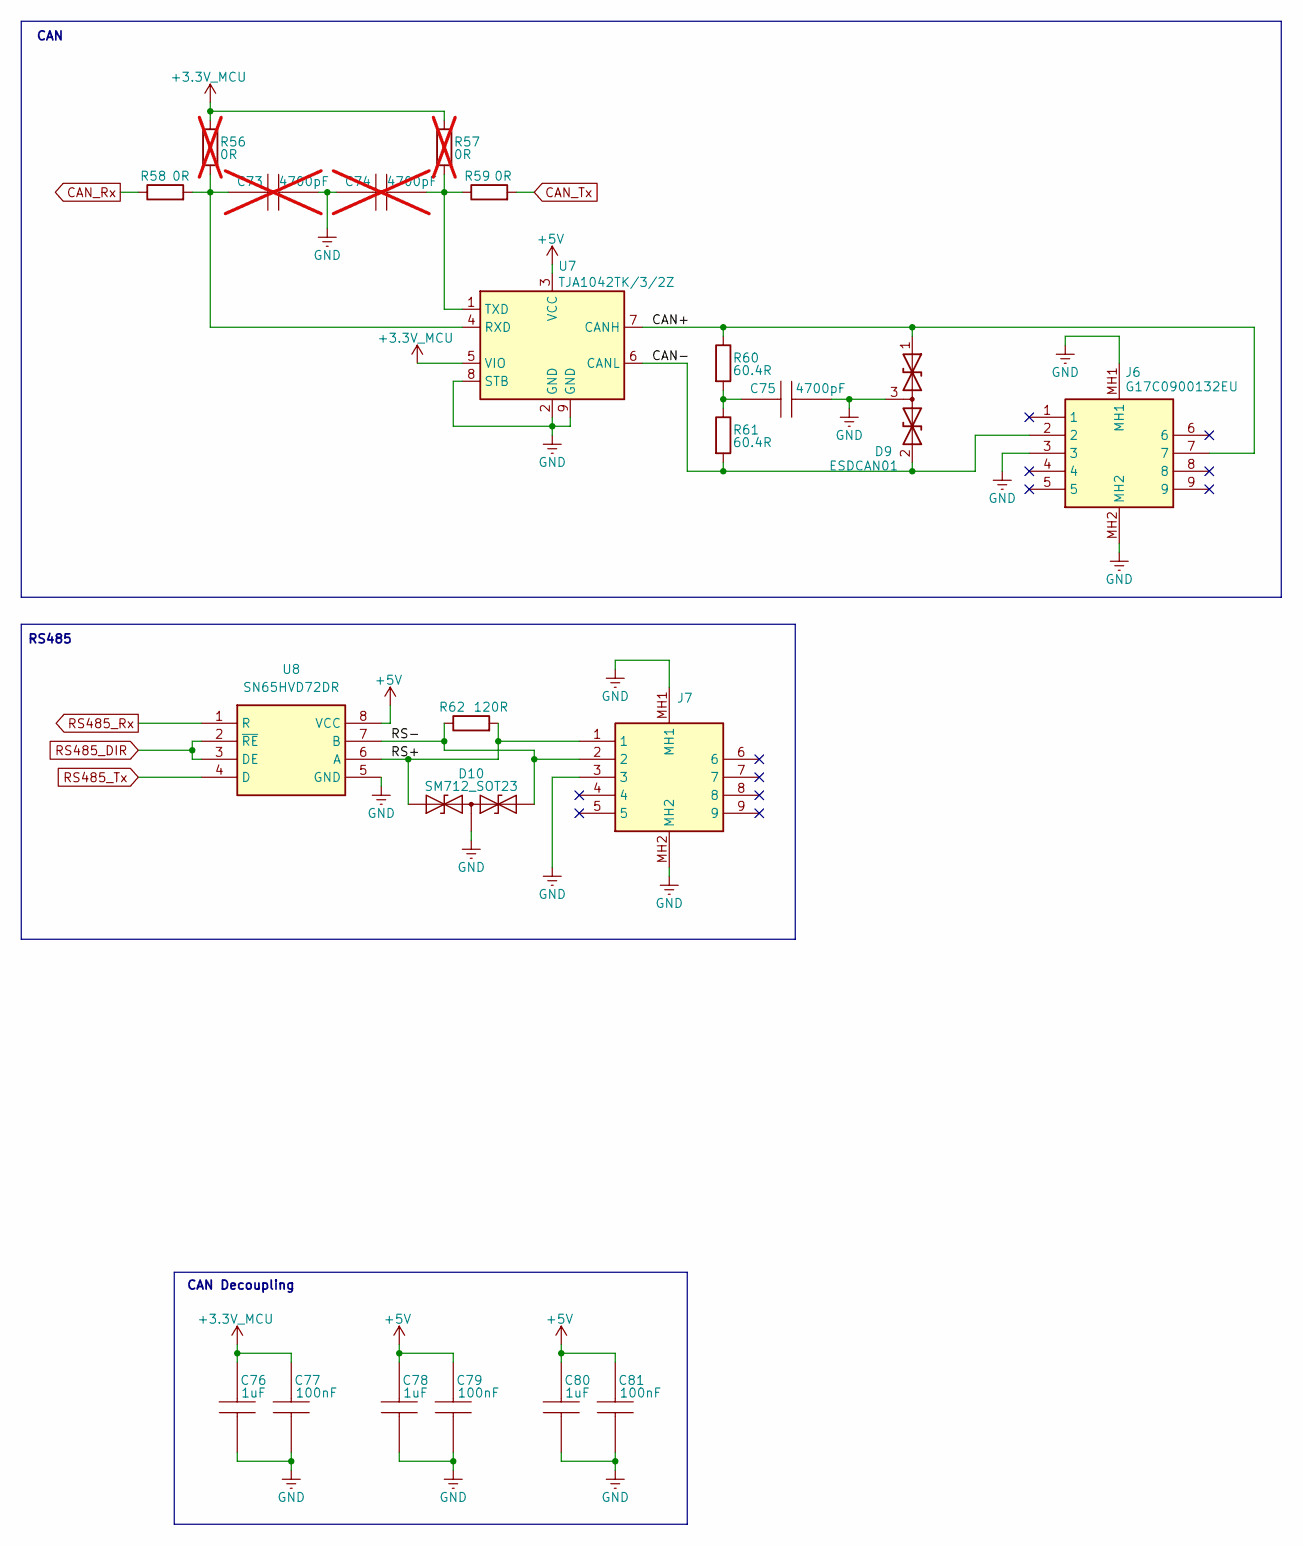
[picture p7: schematic CAN.kicad_sch]

Parts:
C73, C74: 4700pF; C_0603_1608Metric; MPN 885012104008; not fitted
C75: 4700pF; C_0603_1608Metric; MPN 885012104008
C76, C78, C80: 1uF; C_0402_1005Metric; MPN 885012105006
C77, C79, C81: 100nF; C_0402_1005Metric; MPN 885012205092
D9: ESDCAN01; TSOT-23
D10: SM712_SOT23; SOT-23
J6, J7: G17C0900132EU; Mouser Part Number 523-G17C0900132EU
R56, R57: 0R; R_0402_1005Metric; MPN 560112110001; not fitted
R58, R59: 0R; R_0402_1005Metric; MPN 560112110001
R60, R61: 60.4R; R_0402_1005Metric; MPN 560112110170
R62: 120R; R_0402_1005Metric; MPN 560112110001
U7: TJA1042TK/3/2Z; DFN-8-1EP_3x3mm_P0.65mm_EP1.55x2.4mm; MPN TJA1042TK/3/2Z
U8: SN65HVD72DR; SOIC127P600X175-8N; Mouser Part Number 595-SN65HVD72DR

Connections:
+3.3V_MCU: C76.2, C77.2, R56.1, R57.1, U7.5 (VIO); also elsewhere on the board
+5V: C78.2, C79.2, C80.2, C81.2, U7.3 (VCC), U8.8 (VCC); also elsewhere on the board
/CAN & RS485/CAN+: D9.1 (A1), J6.7, R60.1, U7.7 (CANH)
/CAN & RS485/CAN-: D9.2 (A2), J6.2, R61.2, U7.6 (CANL)
/CAN & RS485/RS+: D10.1 (A1), J7.1, R62.2, U8.6 (A)
/CAN & RS485/RS-: D10.2 (A2), J7.2, R62.1, U8.7 (B)
CAN_Rx: R58.1; also elsewhere on the board
CAN_Tx: R59.2; also elsewhere on the board
GND: C73.1, C74.2, C75.1, C76.1, C77.1, C78.1, C79.1, C80.1, C81.1, D9.3 (common), D10.3 (common), J6.3, J6.MH1, J6.MH2, J7.3, J7.MH1, J7.MH2, U7.2 (GND), U7.8 (STB), U7.9 (GND), U8.5 (GND); also elsewhere on the board
unnamed: C75.2, R60.2, R61.1
unnamed: C73.2, R56.2, R58.2, U7.4 (RXD)
unnamed: C74.1, R57.2, R59.1, U7.1 (TXD)
RS485_DIR: U8.2 (~RE), U8.3 (DE); also elsewhere on the board
RS485_Rx: U8.1 (R); also elsewhere on the board
RS485_Tx: U8.4 (D); also elsewhere on the board

Notes on the sheet:
CAN Decoupling
CAN
RS485

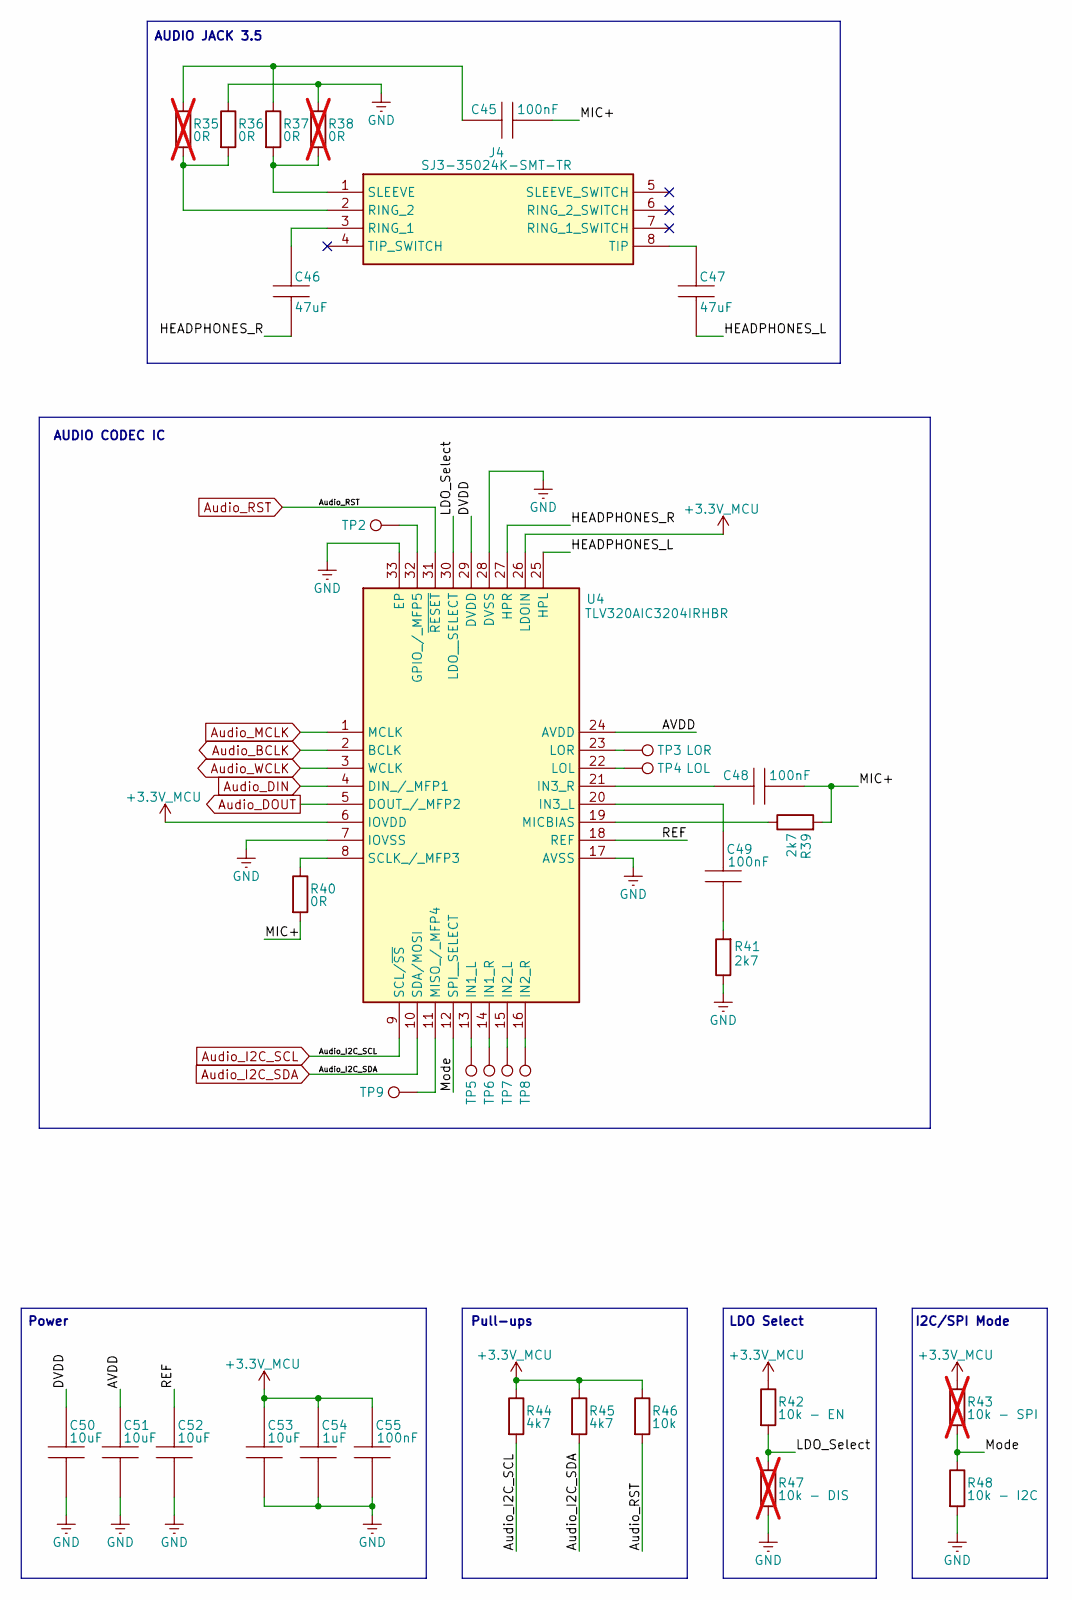
[picture p8: schematic Audio.kicad_sch]

Parts:
C45, C48, C49, C55: 100nF; C_0402_1005Metric; MPN 885012205092
C46, C47: 47uF; C_0805_2012Metric; MPN 885012107006
C50, C51, C52, C53: 10uF; C_0402_1005Metric; MPN 885012105020
C54: 1uF; C_0402_1005Metric; MPN 885012105006
J4: SJ3-35024K-SMT-TR; SJ335024KSMTTR; Mouser Part Number 179-SJ3-35024K-SMTTR
R35, R38: 0R; R_0402_1005Metric; MPN 560112110001; not fitted
R36, R37, R40: 0R; R_0402_1005Metric; MPN 560112110001
R39, R41: 2k7; R_0402_1005Metric; MPN 560112110266
R42: 10k - EN; R_0402_1005Metric; MPN 560112110020
R43: 10k - SPI; R_0402_1005Metric; MPN 560112110020; not fitted
R44, R45: 4k7; R_0402_1005Metric; MPN 560112110245
R46: 10k; R_0402_1005Metric; MPN 560112110020
R47: 10k - DIS; R_0402_1005Metric; MPN 560112110020; not fitted
R48: 10k - I2C; R_0402_1005Metric; MPN 560112110020
TP2, TP5, TP6, TP7, TP8, TP9: TestPoint_0.5mm
TP3: LOR; TestPoint_0.5mm
TP4: LOL; TestPoint_0.5mm
U4: TLV320AIC3204IRHBR; QFN50P500X500X100-33N-D; Mouser Part Number 595-V320AIC3204IRHBR

Connections:
+3.3V_MCU: C53.2, C54.2, C55.2, R42.1, R43.1, R44.1, R45.1, R46.1, U4.6 (IOVDD), U4.26 (LDOIN); also elsewhere on the board
/Audio/AVDD: C51.2, U4.24 (AVDD)
/Audio/DVDD: C50.2, U4.29 (DVDD)
/Audio/HEADPHONES_L: C47.2, U4.25 (HPL)
/Audio/HEADPHONES_R: C46.2, U4.27 (HPR)
/Audio/LDO_Select: R42.2, R47.1, U4.30 (LDO__SELECT)
/Audio/MIC+: C45.1, C48.1, R39.2, R40.2
/Audio/Mode: R43.2, R48.1, U4.12 (SPI__SELECT)
/Audio/REF: C52.2, U4.18 (REF)
Audio_BCLK: U4.2 (BCLK); also elsewhere on the board
Audio_DIN: U4.4 (DIN_/_MFP1); also elsewhere on the board
Audio_DOUT: U4.5 (DOUT_/_MFP2); also elsewhere on the board
Audio_I2C_SCL: R44.2, U4.9 (SCL/~SS); also elsewhere on the board
Audio_I2C_SDA: R45.2, U4.10 (SDA/MOSI); also elsewhere on the board
Audio_MCLK: U4.1 (MCLK); also elsewhere on the board
Audio_RST: R46.2, U4.31 (~RESET); also elsewhere on the board
Audio_WCLK: U4.3 (WCLK); also elsewhere on the board
GND: C50.1, C51.1, C52.1, C53.1, C54.1, C55.1, R36.1, R38.1, R41.1, R47.2, R48.2, U4.7 (IOVSS), U4.17 (AVSS), U4.28 (DVSS), U4.33 (EP); also elsewhere on the board
unnamed: C45.2, R35.1, R37.1
unnamed: C49.1, R41.2
unnamed: C46.1, J4.3 (RING_1)
unnamed: J4.2 (RING_2), R35.2, R36.2
unnamed: J4.1 (SLEEVE), R37.2, R38.2
unnamed: C47.1, J4.8 (TIP)
unnamed: TP2.1, U4.32 (GPIO_/_MFP5)
unnamed: TP5.1, U4.13 (IN1_L)
unnamed: TP6.1, U4.14 (IN1_R)
unnamed: TP7.1, U4.15 (IN2_L)
unnamed: TP8.1, U4.16 (IN2_R)
unnamed: C49.2, U4.20 (IN3_L)
unnamed: C48.2, U4.21 (IN3_R)
unnamed: TP4.1, U4.22 (LOL)
unnamed: TP3.1, U4.23 (LOR)
unnamed: R39.1, U4.19 (MICBIAS)
unnamed: TP9.1, U4.11 (MISO_/_MFP4)
unnamed: R40.1, U4.8 (SCLK_/_MFP3)

Notes on the sheet:
LDO Select
AUDIO JACK 3.5
AUDIO CODEC IC
Power
I2C/SPI Mode
Pull-ups

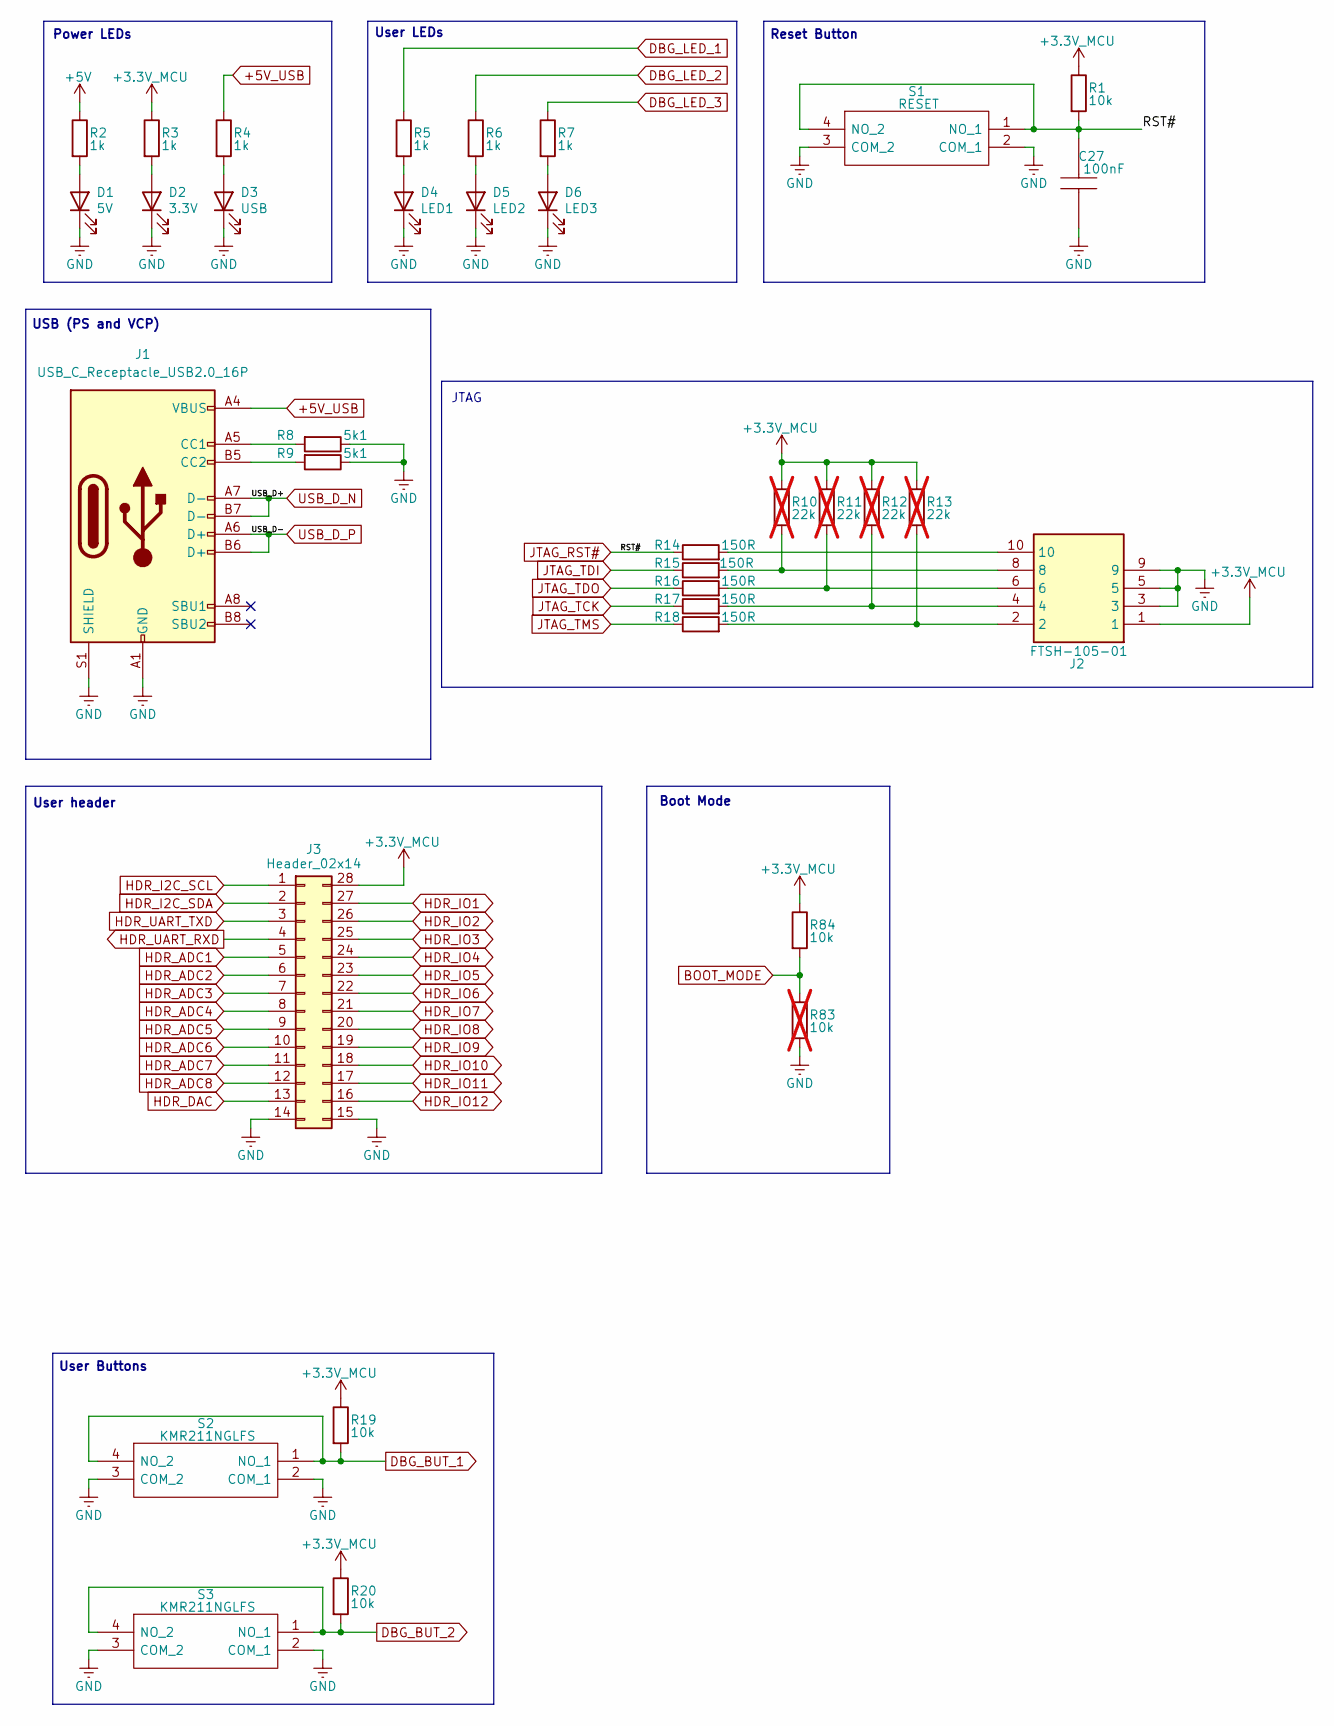
[picture p9: schematic Debug.kicad_sch]

Parts:
C27: 100nF; C_0402_1005Metric; MPN 885012205092
D1: 5V; LED_0805_2012Metric; MPN 150080RS75000
D2: 3.3V; LED_0805_2012Metric; MPN 150080RS75000
D3: USB; LED_0805_2012Metric; MPN 150080RS75000
D4: LED1; LED_0805_2012Metric; MPN 150080RS75000
D5: LED2; LED_0805_2012Metric; MPN 150080RS75000
D6: LED3; LED_0805_2012Metric; MPN 150080RS75000
J1: USB_C_Receptacle_USB2.0_16P; USB_C_Receptacle_GCT_USB4110; MPN USB4110-GF-A
J2: FTSH-105-01; FTSH10501LDV007K; Mouser Part Number 200-FTSH10501LDV7KP
J3: Header_02x14; PinHeader_2x14_P2.54mm_Vertical
R1, R19, R20, R84: 10k; R_0402_1005Metric; MPN 560112110020
R2, R3, R4, R5, R6, R7: 1k; R_0402_1005Metric; MPN 560112110012
R8, R9: 5k1; R_0402_1005Metric; MPN 560112120019
R10, R11, R12, R13: 22k; R_0402_1005Metric; MPN 560112110098; not fitted
R14, R15, R16, R17, R18: 150R; R_0402_1005Metric; MPN 560112110061
R83: 10k; R_0402_1005Metric; MPN 560112110020; not fitted
S1: RESET; KMR211NGLFS-1; Mouser Part Number 611-KMR211NGLFS
S2, S3: KMR211NGLFS; KMR211NGLFS-1; Mouser Part Number 611-KMR211NGLFS

Connections:
+3.3V_MCU: J2.1, J3.28, R1.1, R3.1, R10.1, R11.1, R12.1, R13.1, R19.1, R20.1, R84.1; also elsewhere on the board
+5V: R2.1; also elsewhere on the board
+5V_USB: J1.A4 (VBUS), J1.A9 (VBUS), J1.B4 (VBUS), J1.B9 (VBUS), R4.1; also elsewhere on the board
BOOT_MODE: R83.1, R84.2; also elsewhere on the board
DBG_BUT_1: R19.2, S2.1 (NO_1), S2.4 (NO_2); also elsewhere on the board
DBG_BUT_2: R20.2, S3.1 (NO_1), S3.4 (NO_2); also elsewhere on the board
DBG_LED_1: R5.1; also elsewhere on the board
DBG_LED_2: R6.1; also elsewhere on the board
DBG_LED_3: R7.1; also elsewhere on the board
GND: C27.1, D1.1 (K), D2.1 (K), D3.1 (K), D4.1 (K), D5.1 (K), D6.1 (K), J1.A1 (GND), J1.A12 (GND), J1.B1 (GND), J1.B12 (GND), J1.S1 (SHIELD), J2.3, J2.5, J2.9, J3.14, J3.15, R8.1, R9.1, R83.2, S1.2 (COM_1), S1.3 (COM_2), S2.2 (COM_1), S2.3 (COM_2), S3.2 (COM_1), S3.3 (COM_2); also elsewhere on the board
HDR_ADC1: J3.5; also elsewhere on the board
HDR_ADC2: J3.6; also elsewhere on the board
HDR_ADC3: J3.7; also elsewhere on the board
HDR_ADC4: J3.8; also elsewhere on the board
HDR_ADC5: J3.9; also elsewhere on the board
HDR_ADC6: J3.10; also elsewhere on the board
HDR_ADC7: J3.11; also elsewhere on the board
HDR_ADC8: J3.12; also elsewhere on the board
HDR_DAC: J3.13; also elsewhere on the board
HDR_I2C_SCL: J3.1; also elsewhere on the board
HDR_I2C_SDA: J3.2; also elsewhere on the board
HDR_IO1: J3.27; also elsewhere on the board
HDR_IO2: J3.26; also elsewhere on the board
HDR_IO3: J3.25; also elsewhere on the board
HDR_IO4: J3.24; also elsewhere on the board
HDR_IO5: J3.23; also elsewhere on the board
HDR_IO6: J3.22; also elsewhere on the board
HDR_IO7: J3.21; also elsewhere on the board
HDR_IO8: J3.20; also elsewhere on the board
HDR_IO9: J3.19; also elsewhere on the board
HDR_IO10: J3.18; also elsewhere on the board
HDR_IO11: J3.17; also elsewhere on the board
HDR_IO12: J3.16; also elsewhere on the board
HDR_UART_RXD: J3.4; also elsewhere on the board
HDR_UART_TXD: J3.3; also elsewhere on the board
JTAG_RST#: C27.2, R1.2, R14.1, S1.1 (NO_1), S1.4 (NO_2); also elsewhere on the board
JTAG_TCK: R17.1; also elsewhere on the board
JTAG_TDI: R15.1; also elsewhere on the board
JTAG_TDO: R16.1; also elsewhere on the board
JTAG_TMS: R18.1; also elsewhere on the board
unnamed: D1.2 (A), R2.2
unnamed: D2.2 (A), R3.2
unnamed: D3.2 (A), R4.2
unnamed: D4.2 (A), R5.2
unnamed: D5.2 (A), R6.2
unnamed: D6.2 (A), R7.2
unnamed: J1.A5 (CC1), R8.2
unnamed: J1.B5 (CC2), R9.2
unnamed: J2.2, R13.2, R18.2
unnamed: J2.4, R12.2, R17.2
unnamed: J2.6, R11.2, R16.2
unnamed: J2.8, R10.2, R15.2
unnamed: J2.10, R14.2
USB_D_N: J1.A7 (D-), J1.B7 (D-); also elsewhere on the board
USB_D_P: J1.A6 (D+), J1.B6 (D+); also elsewhere on the board

Notes on the sheet:
User header
User Buttons
Power LEDs
User LEDs
USB (PS and VCP)
JTAG
Reset Button
Boot Mode

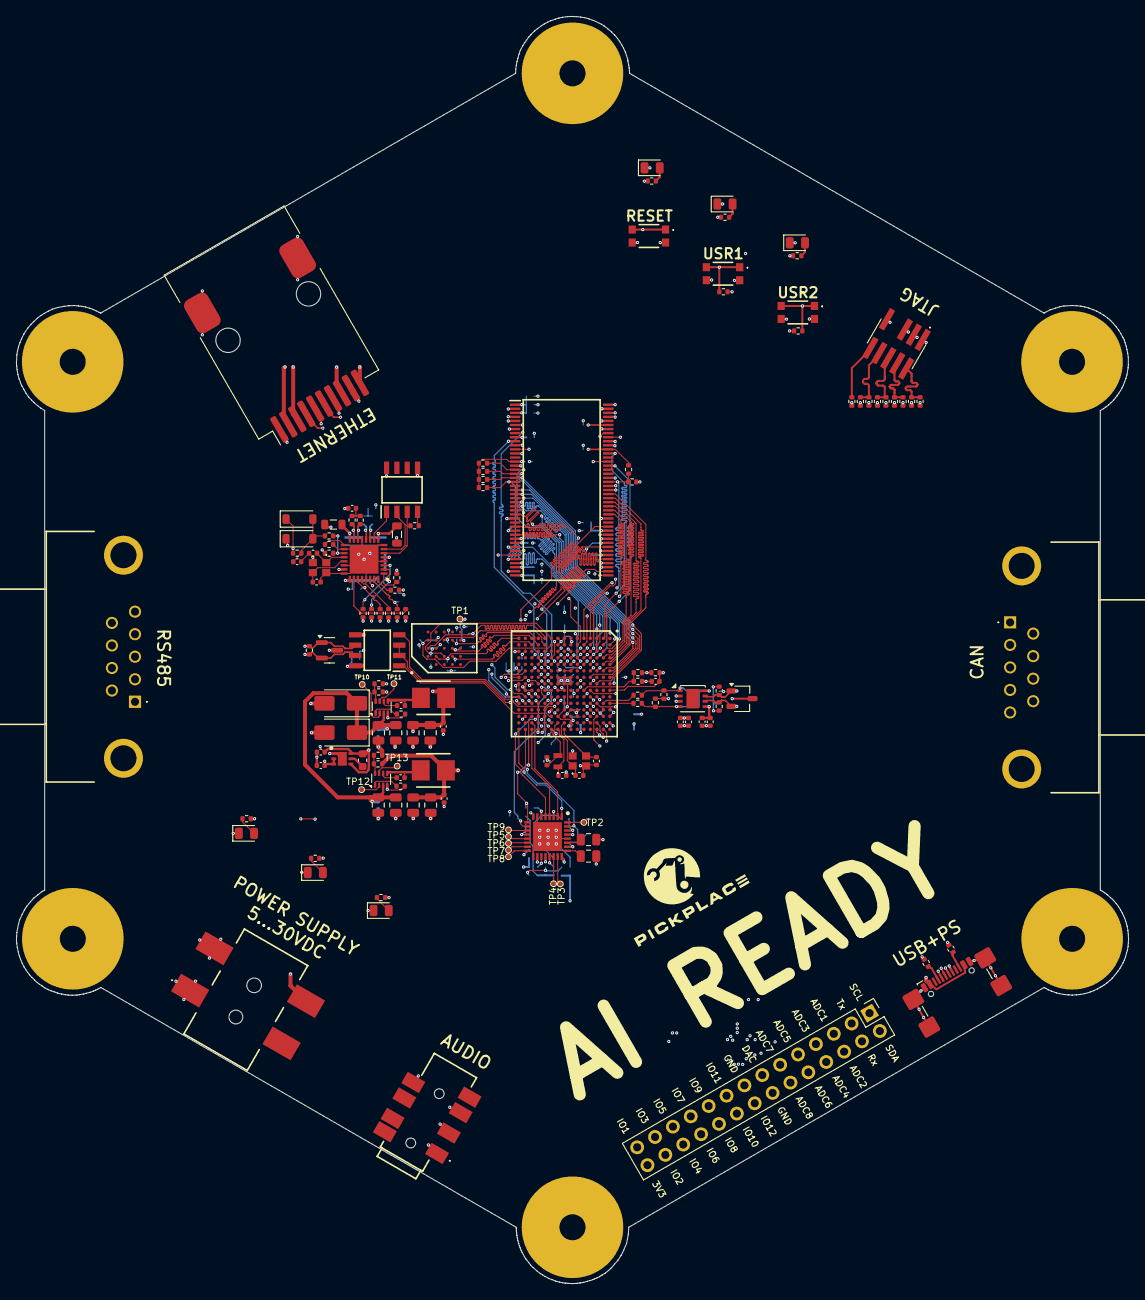
[picture p10: board RA8M1.kicad_pcb from above]

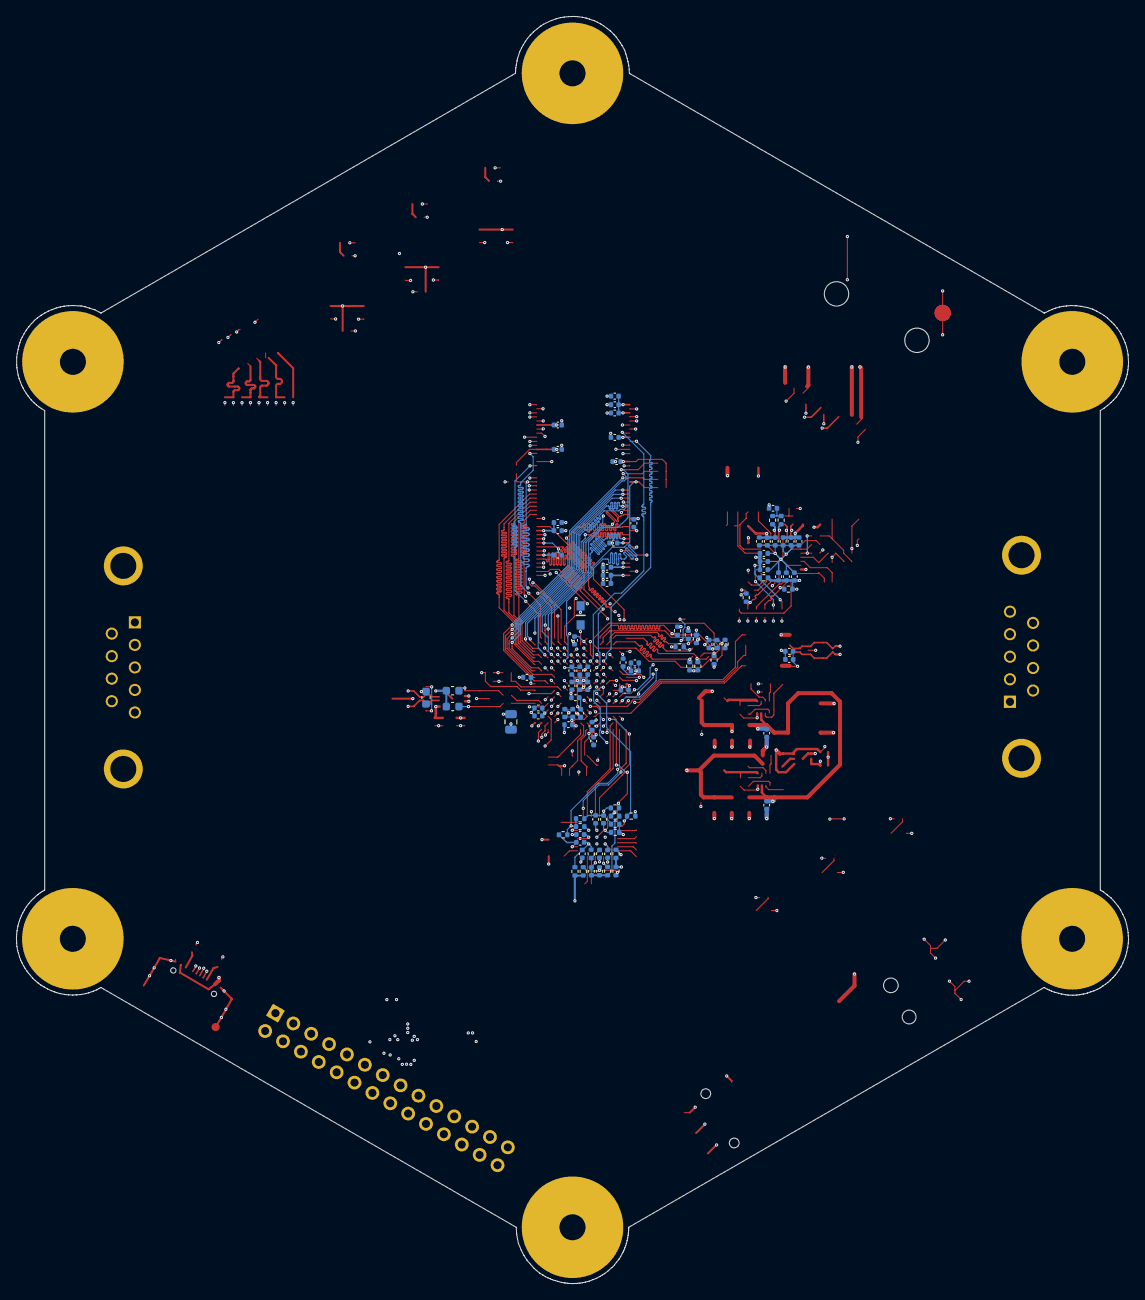
[picture p11: board RA8M1.kicad_pcb from below]

Board: 8 copper layers, 136.9 x 155.9 mm, 236 parts (96 on the bottom side), 221 nets.
