pickplace-de/hexagon/(commit log)

2025-05-13 Ground planes fix
2025-05-26 cosmetic fix
    [RA8M1.kicad_sch]
